el-bart/door_light/doc/README.txt

when programming make sure you select SLOW programming mode (<1MHz). this is
required since programming pins are connected to transistors and fast
communication usually ends up broken.
