el-bart/door_light/doc/pinout.txt

PB0 - IR and RED LEDs on(1)/off(0)
PB1 - light on(1)/off(0)
PB2 - DC/DC on(0)/off(1)
PB3 - photo-transistor input (analog) == ADC3
PB4 - voltage monitor (analog) == ADC2

PB2 - unused
PB5 - reset
