el-bart/door_light/hw-5v/door_light.brd

## EAGLE design hw-5v/door_light.brd (2013-12-13)

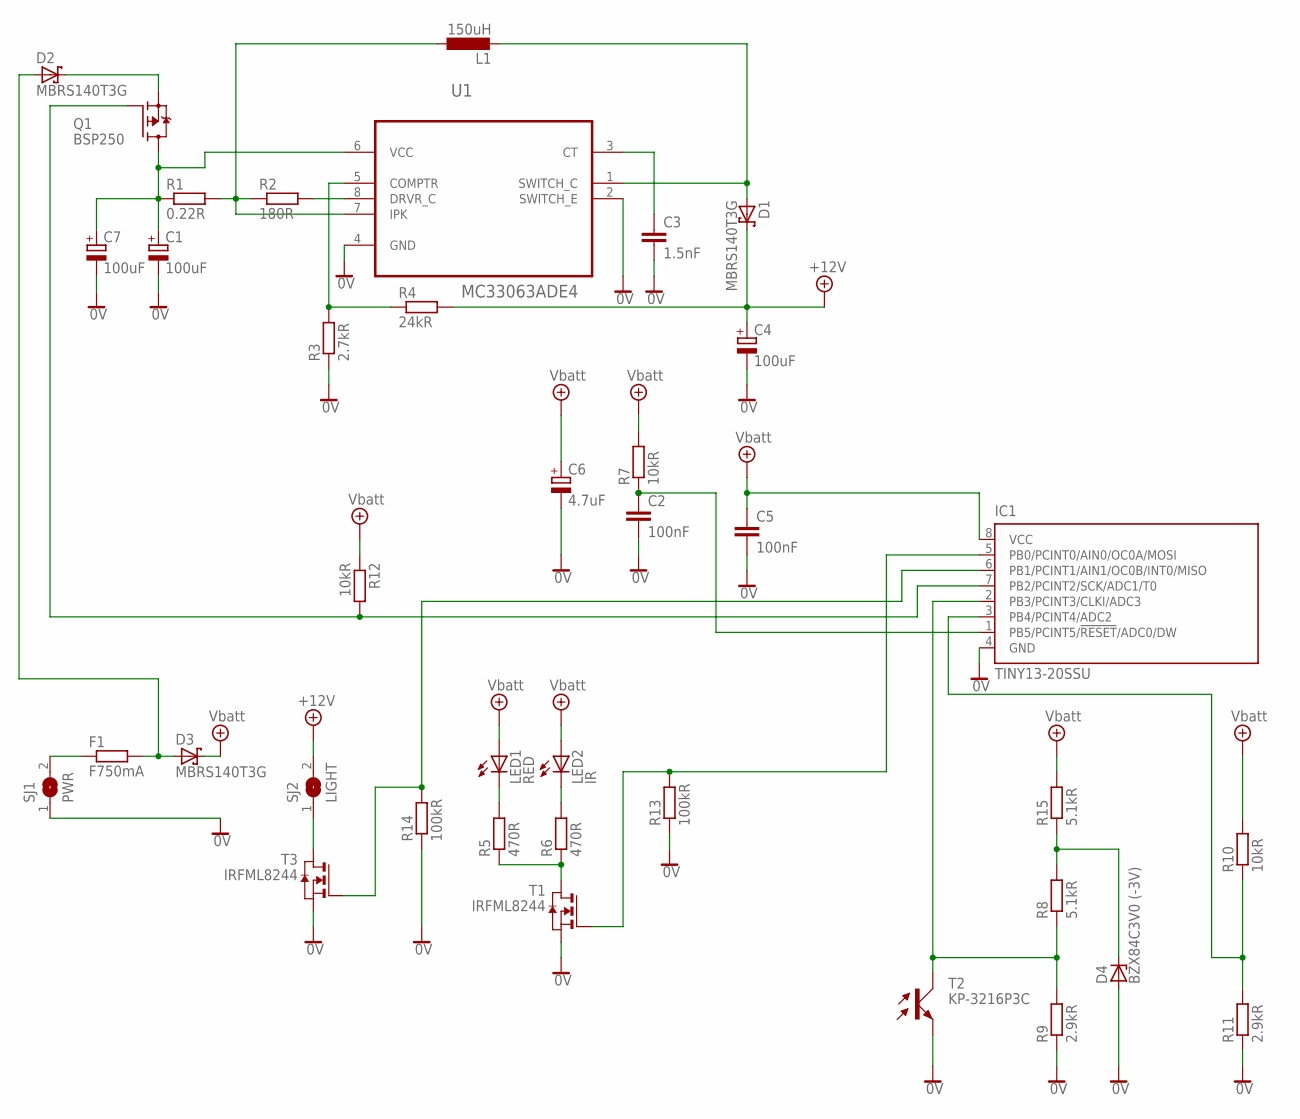
[picture p1: schematic door_light.sch]

Parts:
C1, C4, C7: 100uF; 153CLV-0810
C2, C5: 100nF; C1206
C3: 1.5nF; C1206
C6: 4.7uF; 153CLV-0405
D1, D2, D3: MBRS140T3G; SMB
D4: BZX84C3V0 (-3V); TO236
F1: F750mA; MINI_MELF-0207W
IC1: TINY13-20SSU; 8S1
L1: 150uH; PIS2816
LED1: RED; CHIPLED_0603
LED2: IR; CHIPLED_1206
Q1: BSP250; SOT223
R1: 0.22R; M1206
R2: 180R; R0603
R3: 2.7kR; R0603
R4: 24kR; R0603
R5, R6: 470R; R0603
R7, R10, R12: 10kR; R0603
R8, R15: 5.1kR; R0603
R9, R11: 2.9kR; R0603
R13, R14: 100kR; R0603
SJ1: PWR; SJW
SJ2: LIGHT; SJW
T1, T3: IRFML8244; SOT-23
T2: KP-3216P3C; OPTO-TRANS-SIEMENS_BP103
U1: MC33063ADE4; SOIC127P600X175-8N

Connections:
0V: C1.-, C2.2, C3.2, C4.-, C5.2, C6.-, C7.-, D4.A, IC1.4 (GND), R3.1, R9.1, R11.1, R13.1, R14.1, SJ1.1, T1.2 (S), T2.EMITER (E), T3.2 (S), U1.2 (SWITCH_E), U1.4 (GND)
+4.1V: C5.1, C6.+, D3.C, IC1.8 (VCC), LED1.A, LED2.A, R7.2, R10.2, R12.1, R15.2
+12V: C4.+, D1.C, R4.2, SJ2.2
unnamed: LED1.C, R5.2
unnamed: LED2.C, R6.2
unnamed: C1.+, C7.+, Q1.2 (D), Q1.4 (D), R1.1, U1.6 (VCC)
unnamed: R5.1, R6.1, T1.1 (D)
unnamed: D2.C, Q1.3 (S)
unnamed: D4.C, R8.2, R15.1
unnamed: SJ2.1, T3.1 (D)
unnamed: F1.1, SJ1.2
unnamed: C2.1, IC1.1 (PB5/PCINT5/!RESET!/ADC0/DW), R7.1
unnamed: C3.1, U1.3 (CT)
unnamed: D1.A, L1.2, U1.1 (SWITCH_C)
unnamed: IC1.2 (PB3/PCINT3/CLKI/ADC3), R8.1, R9.2, T2.COLLECTOR (C)
unnamed: IC1.7 (PB2/PCINT2/SCK/ADC1/T0), Q1.1 (G), R12.2
unnamed: IC1.5 (PB0/PCINT0/AIN0/OC0A/MOSI), R13.2, T1.3 (G)
unnamed: R2.2, U1.8 (DRVR_C)
unnamed: L1.1, R1.2, R2.1, U1.7 (IPK)
unnamed: IC1.3 (PB4/PCINT4/ADC2), R10.1, R11.2
unnamed: R3.2, R4.1, U1.5 (COMPTR)
unnamed: IC1.6 (PB1/PCINT1/AIN1/OC0B/INT0/MISO), R14.2, T3.3 (G)
unnamed: D2.A, D3.A, F1.2

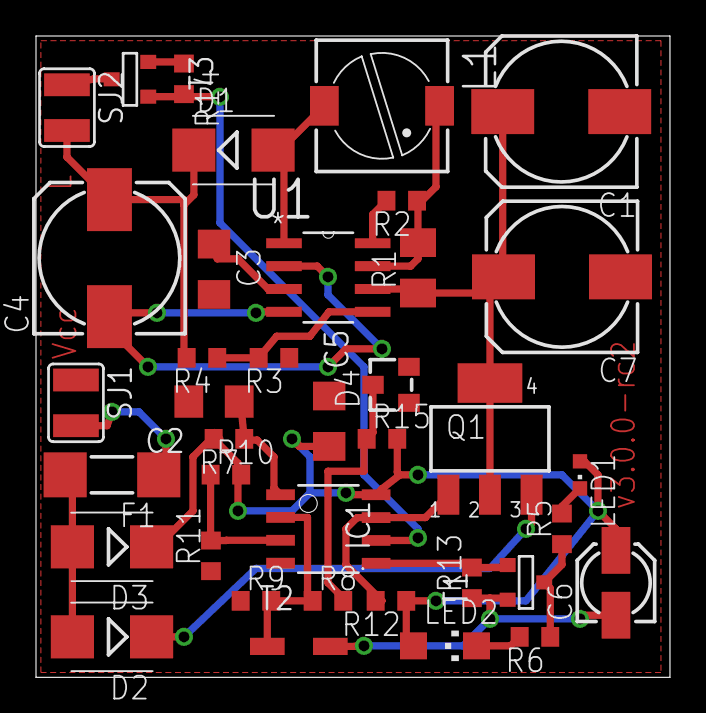
[picture p2: board hw-5v/door_light.brd from above]

Board: 2 copper layers, 35.2 x 35.6 mm, 38 parts (0 on the bottom side), 23 nets.
