el-bart/door_light/hw-12v/door_light.brd

## EAGLE design hw-12v/door_light.brd (2013-11-20)

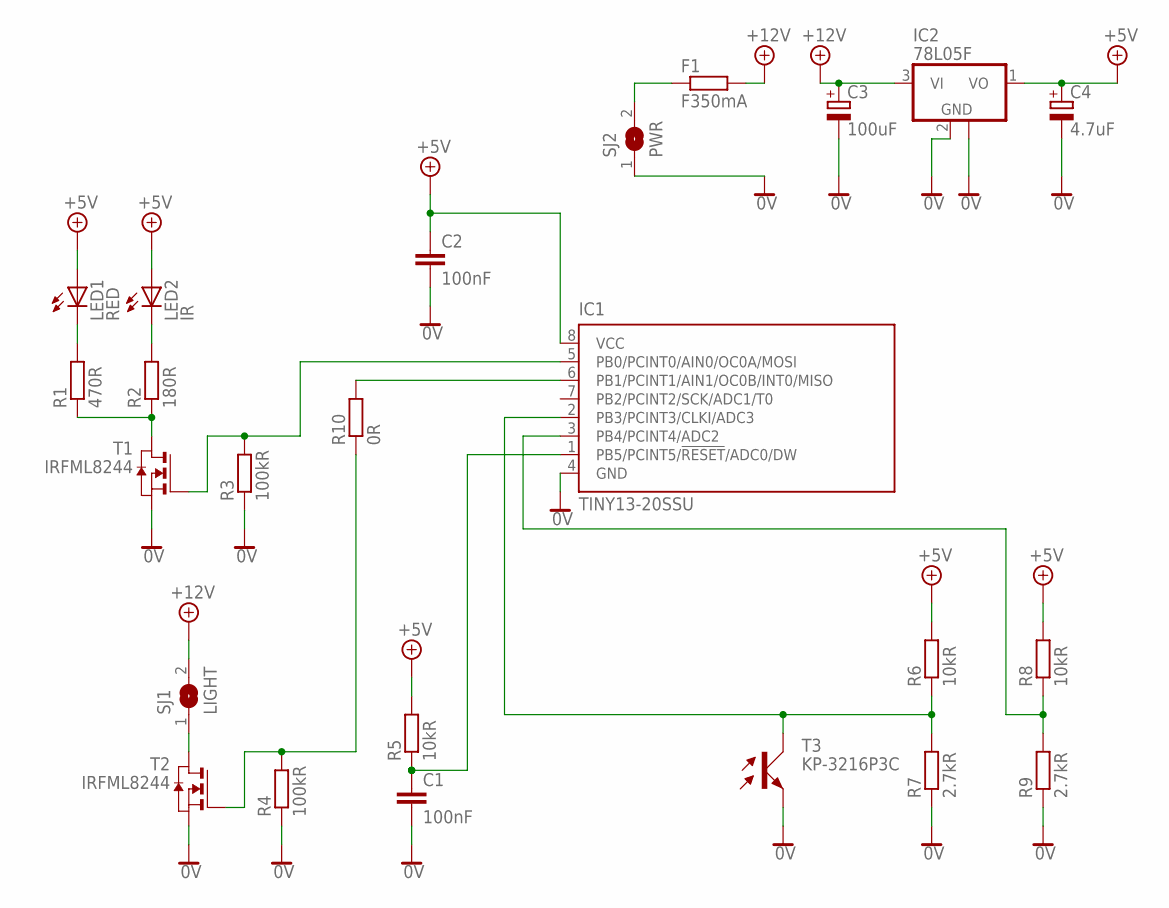
[picture p3: schematic door_light.sch]

Parts:
C1, C2: 100nF; C1206
C3: 100uF; 153CLV-0810
C4: 4.7uF; 153CLV-0405
F1: F350mA; MINI_MELF-0204W
IC1: TINY13-20SSU; 8S1
IC2: 78L05F; SOT89
LED1: RED; CHIPLED_0603
LED2: IR; CHIPLED_1206
R1: 470R; R0603
R2: 180R; R0603
R3, R4: 100kR; R0603
R5, R6, R8: 10kR; R0603
R7, R9: 2.7kR; R0603
R10: 0R; R1206W
SJ1: LIGHT; SJW
SJ2: PWR; SJW
T1, T2: IRFML8244; SOT-23
T3: KP-3216P3C; OPTO-TRANS-SIEMENS_BP103

Connections:
0V: C1.2, C2.2, C3.-, C4.-, IC1.4 (GND), IC2.2 (GND), IC2.2@1 (GND), R3.1, R4.1, R7.1, R9.1, SJ2.1, T1.2 (S), T2.2 (S), T3.EMITER (E)
+5V: C2.1, C4.+, IC1.8 (VCC), IC2.1 (VO), LED1.A, LED2.A, R5.2, R6.2, R8.2
+12V: C3.+, F1.2, IC2.3 (VI), SJ1.2
unnamed: LED1.C, R1.2
unnamed: LED2.C, R2.2
unnamed: SJ1.1, T2.1 (D)
unnamed: R1.1, R2.1, T1.1 (D)
unnamed: R4.2, R10.1, T2.3 (G)
unnamed: F1.1, SJ2.2
unnamed: C1.1, IC1.1 (PB5/PCINT5/!RESET!/ADC0/DW), R5.1
unnamed: IC1.2 (PB3/PCINT3/CLKI/ADC3), R6.1, R7.2, T3.COLLECTOR (C)
unnamed: IC1.6 (PB1/PCINT1/AIN1/OC0B/INT0/MISO), R10.2
unnamed: IC1.5 (PB0/PCINT0/AIN0/OC0A/MOSI), R3.2, T1.3 (G)
unnamed: IC1.3 (PB4/PCINT4/ADC2), R8.1, R9.2

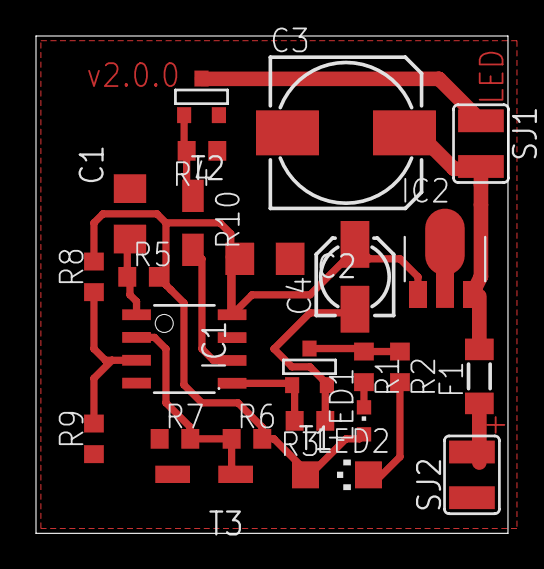
[picture p4: board hw-12v/door_light.brd from above]

Board: 2 copper layers, 26.2 x 27.6 mm, 24 parts (0 on the bottom side), 14 nets.
