el-bart/door_light/src/LedLight.hpp

#ifndef INCLUDE_LEDLIGHT_HPP_FILE
#define INCLUDE_LEDLIGHT_HPP_FILE

#include "config.hpp"
#include "LedBase.hpp"
#include "Pwm.hpp"

/** @brief main light source controlling facility.
 */
class LedLight
{
public:
  explicit LedLight(Pwm& pwm):
    pwm_(pwm)
  {
    fill(Light::lightFill);
    enable(false);
  }

  void fill(const uint8_t f)
  {
    static_assert(Pin::light == _BV(PB1), "PWM set to another channel");    // PWM setup - use OC0B
    pwm_.fillB(f);
  }

  void enable(const bool on)
  {
    pinDcDc_.set(not on);   // P-MOSFET requrest inverted logic
    pwm_.enableB(on);
    if(not on)
      pinLight_.set(false); // make sure pin is down, when PWM has been disabled
  }

private:
  LedBase<Pin::light> pinLight_;
  LedBase<Pin::dcDc>  pinDcDc_;
  Pwm&                pwm_;
};

#endif
