el-bart/door_light/(commit log)

2013-02-19 added hardware board
    [door_light.brd, door_light.sch]
2013-02-21 added version number on board
    [door_light.brd]
2013-02-21 added 3rd version number on board
    [door_light.brd]
2013-02-22 board overlay limited to actual board's size; minor elements' labels re-ordering
    [door_light.brd]
2013-02-26 manual test: application to blink white ledas and control leds
2013-02-28 fuses fixed...
2013-02-28 new build v2.3.1 with protection agains accidental fuses overwrite
2013-02-28 marked ADC number of phototransistor pin
2013-11-08 TODO added - new idea on how to make the board
2013-11-09 documentation update - now PCB is SMD
    [door_light.brd, door_light.sch]
2013-11-09 activeated more layers on pcb view
    [door_light.brd]
2013-11-10 fixed resistor voltage divider
    [door_light.brd, door_light.sch]
2013-11-10 pads for power and LED connecting are now SMD as well
    [door_light.brd, door_light.sch]
2013-11-12 coil type changed (bigger one)
    [door_light.brd, door_light.sch]
2013-11-12 minor alignment update on PCB
    [door_light.brd]
2013-11-12 rc-number changed on PCB (not yet labeled though)
    [door_light.brd]
2013-11-14 fixed IR led size (was 805, should be 1206)
    [door_light.brd, door_light.sch]
2013-11-14 replaced fuse with the one of a proper type and size (1812)
    [door_light.brd, door_light.sch]
2013-11-14 fixed labels on PCB
    [door_light.brd]
2013-11-14 blink code update to blink all ports at once (for now)
    [door_light.brd]
2013-11-14 fixed invalid path under LED1
    [door_light.brd]
2013-11-14 180R size changed from 1206 to 603
    [door_light.brd, door_light.sch]
2013-11-14 DC/DC converter is nowe powered...
    [door_light.brd, door_light.sch]
2013-11-14 added missing R to GND from transistors' gates
    [door_light.brd, door_light.sch]
2013-11-14 minor fixes and first poritng steps forward new software version
    [config.hpp, main.cpp]
2013-11-15 Adc moved to separate file + code updated to use new setup
2013-11-15 added dropping 2 least signifficant bits from ADC as a noise
    [Adc.hpp]
2013-11-15 example application blinking in a way reflecting voltage change
2013-11-15 readme added to state that device needs to be programmed in a slow mode
2013-11-15 Leds now have separate control classes
2013-11-15 updated 'off' application to new board
2013-11-15 Sampler - class keeping multiple samples of data in a circular buffer
2013-11-15 added power saving mode class
2013-11-15 Pwm is a work in progress
2013-11-15 PWM integration to main has started
2013-11-15 ligh controlling classes are to be reworked
    [LedCtrl.hpp, LedLight.hpp]
2013-11-15 adding enable/disable and fill() to PWM usage (Led*) - work in progress
2013-11-15 fixed values being set
    [Pwm.hpp]
2013-11-15 default fill for ctrl leds is now in config
2013-11-15 fixed PWM to work as expected, when connected to p-mosfet on output
    [LedCtrl.hpp, LedLight.hpp, Pwm.hpp]
2013-11-15 added method for obtaining PWM's frequency (at compile time)
2013-11-15 replaced on-bard big fuse with the smaller one (the one that has been actually bought)
    [door_light.brd, door_light.sch]
2013-11-15 Millivolts is now global typedef; draft for the low power handling facility
2013-11-18 low power handle has been implemented and is checked once a second
2013-11-18 added TODOs for 5v version of the hardware
    [door_light.brd, door_light.sch]
2013-11-18 more TODOs for 12v schematic
2013-11-18 fixed few not-so-bright-namings on the schemas
    [door_light.brd, door_light.sch]
2013-11-18 added n-mosfet datasheet
2013-11-18 IR LED's current note
2013-11-18 added more verbose datasheet on IR diode
2013-11-18 reverting last commit on main.cpp
    [main.cpp]
2013-11-18 new 12V schema
    [door_light.brd, door_light.sch]
2013-11-18 recalculated some resitors values
    [door_light.brd, door_light.sch]
2013-11-19 elements are now more compact
    [door_light.brd]
2013-11-19 fixed coliding Vcc and GND on board layout
    [door_light.brd, door_light.sch]
2013-11-19 fixed R5 size (was 40x should be 603)
    [door_light.brd, door_light.sch]
2013-11-19 fuse changed from 750mA to 350mA
    [door_light.brd, door_light.sch]
2013-11-20 PWM::frequency() now returns more accurate value
2013-11-20 Sampler::average() added
2013-11-20 fixed ADC disabing; removed dropping 2lsbs of ADC result as a noise - nosise is being averaged elsewhere
    [Adc.hpp]
2013-11-20 fixed PWM for channel B which is now n-mosfet as well (inverted polarity is NOT required)
    [Pwm.hpp]
2013-11-20 fixed light led control + both led derive privately from implementation
    [LedCtrl.hpp, LedLight.hpp]
2013-11-20 Sampler has now fill() and size() methods
2013-11-20 main now works fine with real power leds turned on as well
2013-11-20 working version w/o Sampler - just simple 'prev' value, updated during start() and once a second
2013-11-20 minimum Vcc is now 3.3[V] (3x1.1 == 3x low-power eneloops)
2013-11-20 low power handler has been reworked to have check and halt() calls separate, to allow user's code to be added, before halting
    [LowPowerHandler.hpp]
2013-11-20 added low power handing code to main()
2013-11-20 minor style and comment fixed + constants improvements
    [config.hpp, main.cpp]
2013-11-20 fixed issue with fluoroluminescence light by adding average values of measurements
    [config.hpp, main.cpp]
2013-11-20 changed board name to v2.0.0 on 12V version
    [door_light.brd]
2013-12-04 12V version schema is ready, TODOs fixed; PCB is draft-done - to be tested and improved
    [door_light.brd, door_light.sch]
2013-12-05 route fixes; changed fuse to bigger package (1A)
    [door_light.brd, door_light.sch]
2013-12-09 added FIR filter model (octave file)
2013-12-12 fixed invalid 10kR resistor size
    [door_light.brd, door_light.sch]
2013-12-12 fixed invalid p-mosfet control
    [LedLight.hpp]
2013-12-12 comments fixes; added constant for grace on-time
    [main.cpp]
2013-12-12 added todo o missing resistor
2013-12-12 size of the binary decreased thanks to dividing by the power of 2
2013-12-12 TODO added on IR measuring for 5V version
2013-12-13 fixed BSP250's pull-down to be a pull-up (10kR)
    [door_light.brd, door_light.sch]
2013-12-13 added -3V zenner for ensuring reasonable measurements of IR light change
    [door_light.brd, door_light.sch]
